cornell-cup/ece-minibot-pcb-sp16/minibot_final_sp16 (PCB - Pour Copper Report).txt

Pour Copper Report
------------------

Report File:        D:\Spring 2016\Minibot\ece-minibot-pcb-sp16\minibot_final_sp16 (PCB - Pour Copper Report).txt
Report Written:     Monday, May 09, 2016
Project Path:       D:\Spring 2016\Minibot\ece-minibot-pcb-sp16\minibot_final_sp16.prj
Design Path:        D:\Spring 2016\Minibot\ece-minibot-pcb-sp16\minibot_final_sp16.pcb
Design Title:       
Created:            5/3/2016 6:45:54 AM
Last Saved:         5/9/2016 8:59:37 PM
Editing Time:       950 min
Units:              mil (precision 2)

End Of Report.
