cornell-cup/ece-minibot-pcb-sp16/Mini-ModBot Hardware Integration - Port_Pin Mapping.xlsx

Sheet: Pin mapping by Aish
Mini-ModBot Hardware Integration - Port/Pin Mapping
System | Component (If Applicable) | Port/Pin# | Port/Pin Name | Port/Pin Conflict? | If Yes, Conflict Description | Other
Motor control
 | Motor (Back) | --- | PWM
 |  | --- | PWM
 | Encoder (Back) | --- | GPIO
 | Servo (Front) | --- | Connect to PIC
 | PIC | --- | SPI Line 1
 |  | --- | SPI Line 2
PS4 controller
 | Bluetooth | --- | Bluetooth
Temperature Sensor
 | LM35 | --- | Analog Pin |  |  | Currently MIA, Need to order another if not found
Color Sensor
 | Adafruit TCS34725 RGB Color Sensor | SDA | SDA (I2C)
 |  | SCL | SCL (I2C)
IMU
 | Adafruit - BNO055 - 9-DOF IMU | SDA | SDA (I2C)
 |  | SCL | SCL (I2C)
LIDAR
 | Neato LIDAR XV-11 | RX | UART
 |  | TX | UART
Camera
 | Logitech Webcam C525 | USB | USB
Power
 | Li-Ion 11.1V Rechargeable Battery | --- | Power Supply (ADC?) |  |  | Requires power regulator (integrated on PCB)
Battery Indicator
 | LED/Buzzer | --- | GPIO |  |  | Requires voltage divider (integrated on PCB)

Sheet: Pin mapping - Aparna
Mini-ModBot Hardware Integration - Port/Pin Mapping
System | Component (If Applicable) | Port/Pin Name | Shield Pin # | GPIO Pin # | Other pin options (shield pin) | Port/Pin Conflict? | If Yes, Conflict Description | Other
Motor control
 | Motor (Back) | PWM | ~3 | GP183 | ~5, ~6, ~9
 | Encoder (Back) | GPIO | 7 | GP48
 | Servo (Front) | Connect to PIC | ---
 | PIC | SPI SCK | 13 | GP109
 |  | SPI MISO | 12 | GP114
 |  | SPI MOSI | ~11 | GP115
 |  | SPI Signal select | ~10 | GP111
PS4 controller
 | Bluetooth | Bluetooth | ---
Temperature Sensor
 | LM35 | Analog Pin | A0 | GP44 | A2, A3 |  |  | Currently MIA, Need to order another if not found
Color Sensor
 | Adafruit TCS34725 RGB Color Sensor | SDA (I2C) | SDA
 |  | SCL (I2C) | SCL
IMU
 | Adafruit - BNO055 - 9-DOF IMU | SDA (I2C) | A4 (I2C6_SDA) | GP27
 |  | SCL (I2C) | A5 (I2C6_SCL) | GP28
LIDAR
 | Neato LIDAR XV-11 | UART | RX | GP130
 |  | UART | TX | GP131
Camera
 | Logitech Webcam C525 | USB | USB
Power
 | Li-Ion 11.1V Rechargeable Battery | Power Supply (ADC?) | A1 | GP45 | A2, A3 |  |  | Requires power regulator (integrated on PCB)
Battery Indicator
 | LED/Buzzer | GPIO | 8 | GP49 |  |  |  | Requires voltage divider (integrated on PCB)

Sheet: Reference for hardware
Table 8 in Hardware manual : | http://www.intel.com/content/dam/support/us/en/documents/edison/sb/edisonarduino_hg_331191007.pdf
GPIO Pin mapping : | Table 2 - Shield pin GPIO mapping | http://www.intel.com/content/dam/support/us/en/documents/edison/sb/edisonarduino_hg_331191007.pdf

Sheet: Pin mapping - Tahmid
Mini-ModBot Hardware Integration - Port/Pin Mapping
System | Component (If Applicable) | Port/Pin Name | Shield Pin # | GPIO Pin # | Other pin options (shield pin) | Port/Pin Conflict? | If Yes, Conflict Description | Other
Motor control
 | Motor (Back) | PWM | ~3 | GP183 | ~5, ~6, ~9
 |  | PWM | ~5
 | Encoder (Back) | GPIO | 7 | GP48
 | Servo (Front) | Connect to PIC | ---
 | PIC | SPI SCK | 13 | GP109
 |  | SPI MISO | 12 | GP114
 |  | SPI MOSI | ~11 | GP115
 |  | SPI Signal select | ~10 | GP111
PS4 controller
 | Bluetooth | Bluetooth | ---
Temperature Sensor | x2
 | LM35 | Analog Pin | A0 | GP44 | A2, A3 |  |  | Currently MIA, Need to order another if not found
Color Sensor
 | Adafruit TCS34725 RGB Color Sensor | SDA (I2C) | SDA
 |  | SCL (I2C) | SCL
IMU
 | Adafruit - BNO055 - 9-DOF IMU | SDA (I2C) | A4 (I2C6_SDA) | GP27
 |  | SCL (I2C) | A5 (I2C6_SCL) | GP28
LIDAR
 | Neato LIDAR XV-11 | UART | RX | GP130
Camera
 | Logitech Webcam C525 | USB | USB
Power
 | Li-Ion 11.1V Rechargeable Battery | Power Supply (ADC?) | A1 | GP45 | A2, A3 |  |  | Requires power regulator (integrated on PCB)
Battery Indicator
 | LED/Buzzer | GPIO | 8 | GP49 |  |  |  | Requires voltage divider (integrated on PCB)
2x motor drive
Detecting when charger is plugged in |  | Disable motors, lidar and rgb
Charger mounted on top of rear motor bracket
No TFT LCD for this rev
2x LM35 - mount 1 on battery (?) and 1 for surroundings
2 GPIOs for RGB LED
Power Regulator
Reverse voltage protection
Check all 3.3V nets
Find bulk capacitors
Break out edison analog pins |  | http://www.digikey.com/product-detail/en/sullins-connector-solutions/PPPC031LFBN-RC/S7036-ND/810175
Break out edison uart pins |  | http://www.digikey.com/product-detail/en/sullins-connector-solutions/PPPC031LFBN-RC/S7036-ND/810175
Allow connecting edison aref/ioref to onboard psu
Break out 5V/3.3V outputs |  | http://www.digikey.com/product-detail/en/sullins-connector-solutions/PPTC051LFBN-RC/S6103-ND/807239
Switch |  | http://www.digikey.com/product-detail/en/c-k-components/1101M2S4AQE2/CKN5050-ND/483720
Fuse/circuit breaker
Removed decoupling cap on IMU - C1
Lidar switch for switching between 3.3V/5V
PIC inductor on AVDD/Vss
Unused IO pull-down?
MCLR connection cap?
AREF/IOREF on Edison
