cornell-cup/ece-minibot-pcb-sp16/battery indicator.PNG

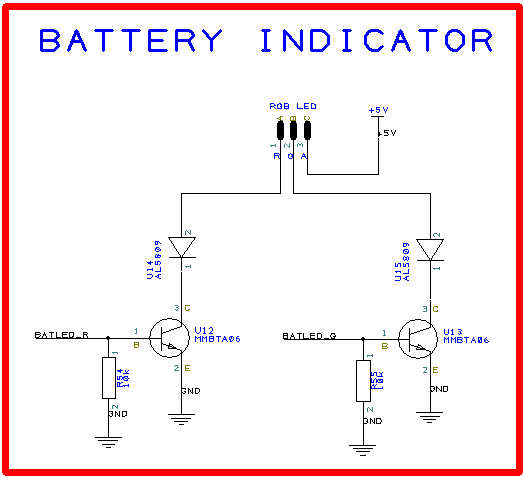
battery indicator.PNG
