cornell-cup/ece-minibot-pcb-sp16/charging.png

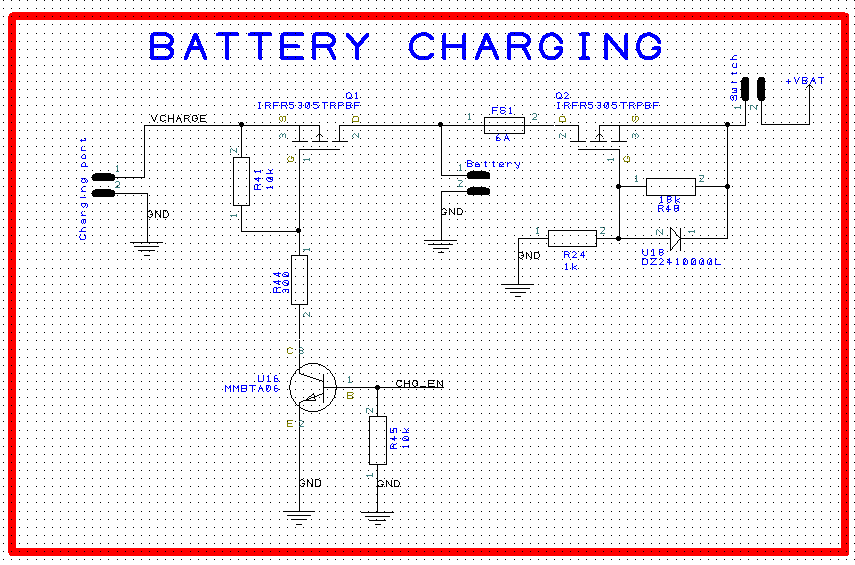
charging.png
