cornell-cup/ece-minibot-pcb-sp16/edison.png

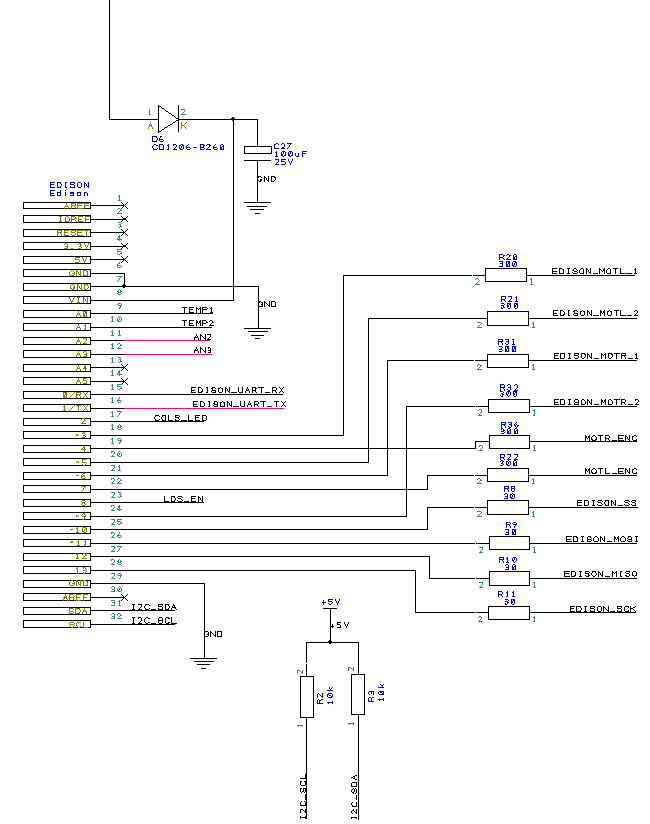
edison.png
