cornell-cup/ece-minibot-pcb-sp16/lidar.PNG

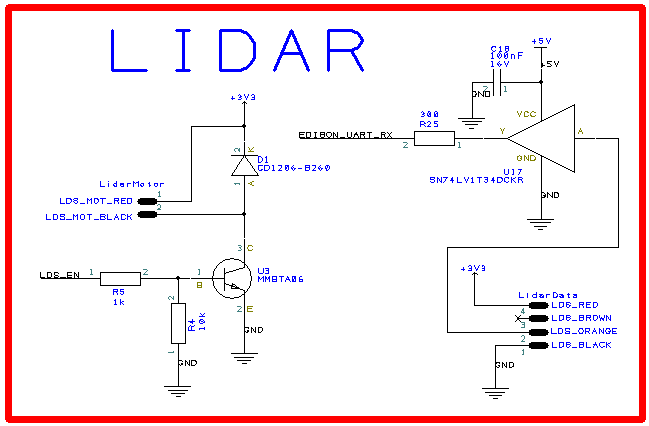
lidar.PNG
