cornell-cup/ece-minibot-pcb-sp16/motor driver.png

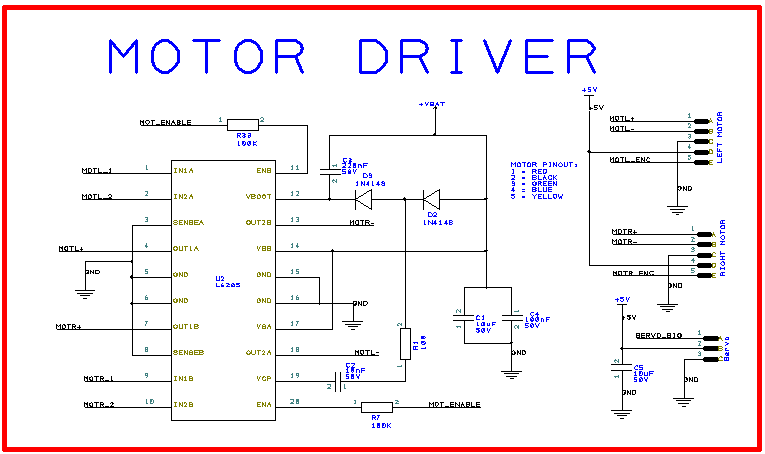
motor driver.png
