cornell-cup/ece-minibot-pcb-sp16/mux.PNG

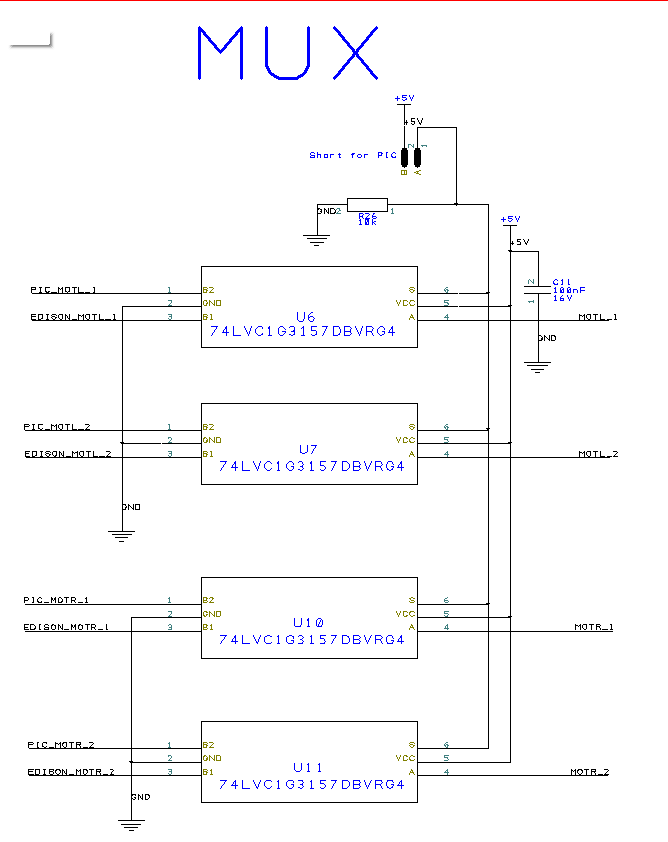
mux.PNG
