cornell-cup/ece-minibot-pcb-sp16/pic32.PNG

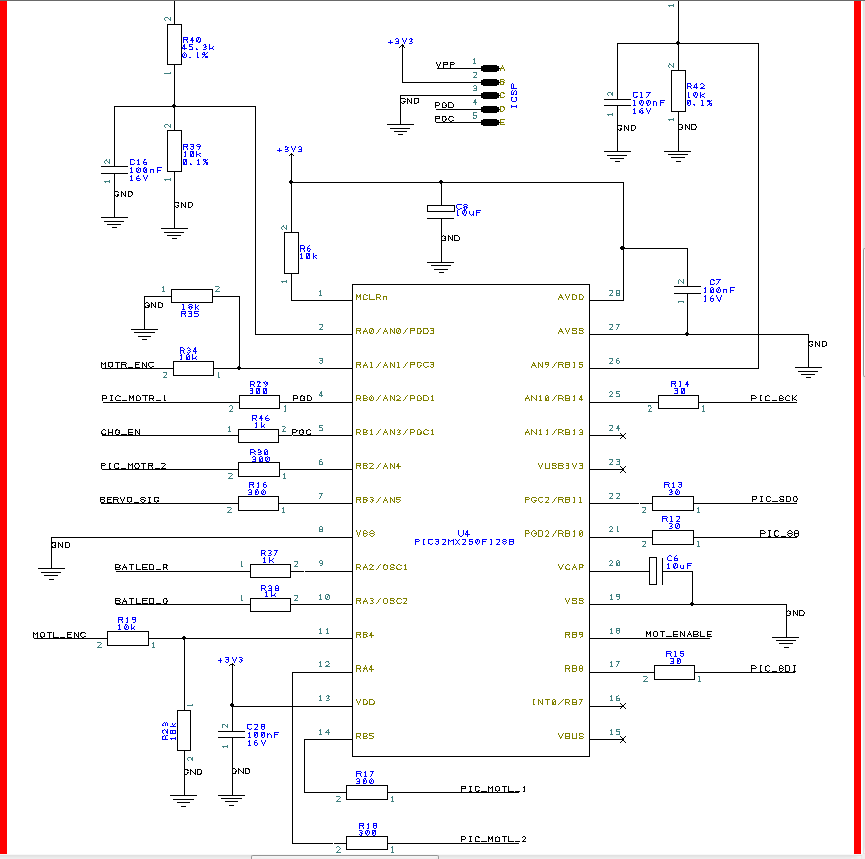
pic32.PNG
