cornell-cup/ece-minibot-pcb-sp16/power.png

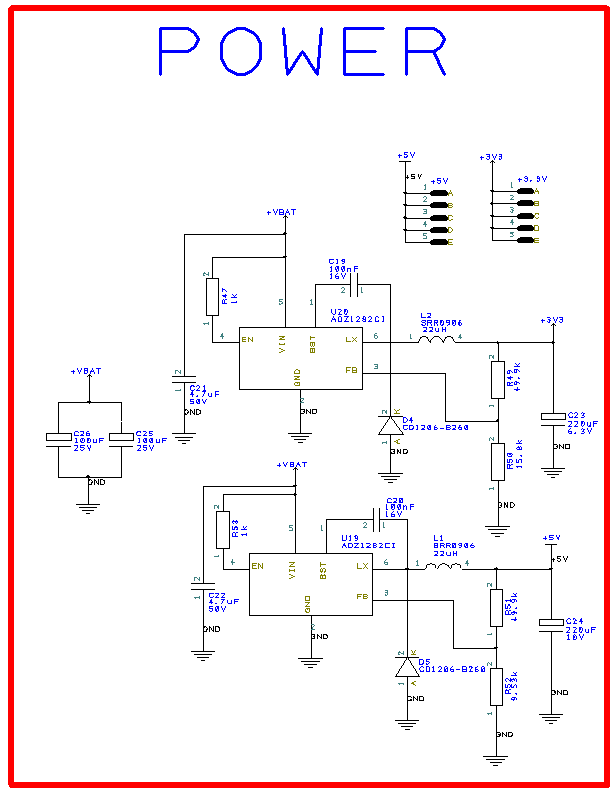
power.png
