cornell-cup/ece-minibot-pcb-sp16/temperature sensors.PNG

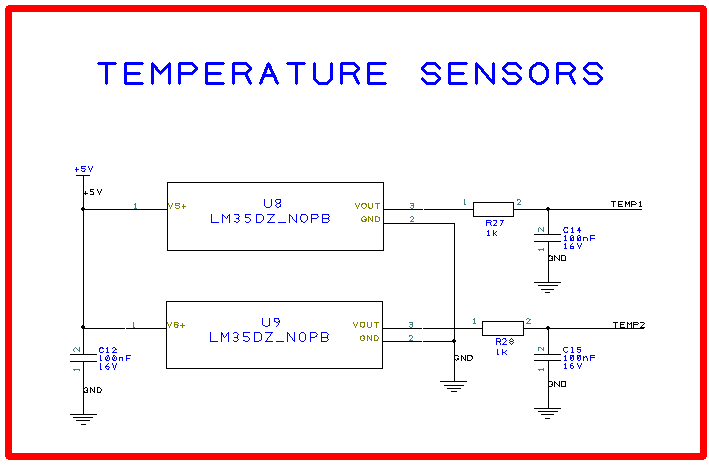
temperature sensors.PNG
