cornell-cup/ece-minibot-pcb-sp16/Schematic Design_ minibot_final_sp16.pdf

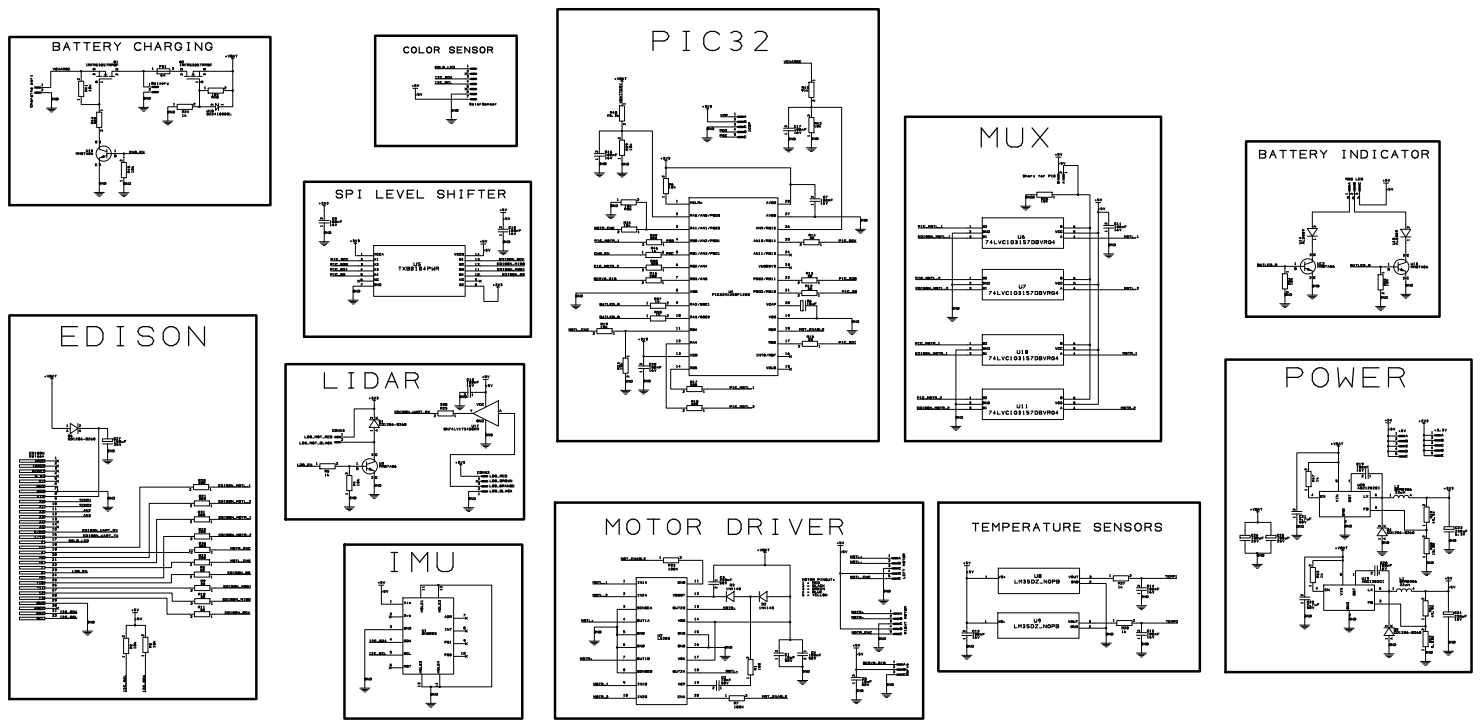
[picture p10: page 1]
