cornell-cup/ece-minibot-pcb-sp16/(list of files, drawings)

Other design files:
minibot_final_sp16.pcb
~minibot_final_sp16.pcb
