cornell-cup/ece-minibot-pcb-sp16/(commit log)

2016-05-03 Things are still being added to schematic. PIC32 added!
    [minibot_final_sp16.pcb, minibot_final_sp16.sch, ~minibot_final_sp16.sch]
2016-05-03 Still adding components on first pass
    [minibot_final_sp16.sch, ~minibot_final_sp16.sch]
2016-05-04 Adding more of the circuit in place to the schematic. Also, added excel pins list.
    [minibot_final_sp16.sch, ~minibot_final_sp16.sch]
2016-05-04 More things added to schematic
    Power, battery charging (and detection/prevention), color sensor,
    battery indicated (RGB LED driver) left to be added. Then, it should be
    complete.
    [Mini-ModBot Hardware Integration - Port_Pin Mapping.xlsx, minibot_final_sp16.pcb, minibot_final_sp16.sch, ~minibot_final_sp16.sch]
2016-05-04 LED driver and ICSP header added.
    [minibot_final_sp16.sch, ~minibot_final_sp16.sch]
2016-05-05 Schematic mostly done
    Power regulators, color sensor, ... placed in schematic. Now need to
    make sure nothing is left out. And pick connector for battery.
    [Mini-ModBot Hardware Integration - Port_Pin Mapping.xlsx, minibot_final_sp16.sch, ~minibot_final_sp16.sch]
2016-05-05 Mostly complete. Reviewing.
    [Mini-ModBot Hardware Integration - Port_Pin Mapping.xlsx, minibot_final_sp16.pcb, minibot_final_sp16.sch, ~minibot_final_sp16.sch]
2016-05-06 Only switch left to be placed on schematic
    [Mini-ModBot Hardware Integration - Port_Pin Mapping.xlsx, minibot_final_sp16.sch, ~minibot_final_sp16.sch]
2016-05-06 Switch still left. Couple points of feedback from Aparna incorporated.
    [Mini-ModBot Hardware Integration - Port_Pin Mapping.xlsx, minibot_final_sp16.pcb, minibot_final_sp16.sch]
2016-05-07 Replacing 1206 resistors with 0603
    All 10k and 300 ohms resistors have been replaced.
    [minibot_final_sp16.pcb, minibot_final_sp16.sch]
2016-05-07 Replaced 1k resistors to 0603
    [minibot_final_sp16.pcb, minibot_final_sp16.sch]
2016-05-07 All resistors except precision ones changed to 0603
    [minibot_final_sp16.sch]
2016-05-07 Replacing the 1206 capacitors
    [minibot_final_sp16.pcb, minibot_final_sp16.sch]
2016-05-07 Renamed connectors and named all nets
    [minibot_final_sp16 (bill of materials CSV).csv, minibot_final_sp16.pcb, minibot_final_sp16.sch]
2016-05-07 Actually renamed everything correctly.
    Started thinking about component placement on board.
    [minibot_final_sp16.pcb, minibot_final_sp16.sch]
2016-05-07 Updated pdf view of schematic
    [minibot_final_sp16.pcb, minibot_final_sp16.sch]
2016-05-07 Power components grouped together
    [minibot_final_sp16.pcb, minibot_final_sp16.sch, ~minibot_final_sp16.pcb]
2016-05-07 RGB, Ilimit Res
    RGB block grouped together. Edison current limiting and "terminating"
    resistors placed near header.
    [minibot_final_sp16.pcb]
2016-05-07 Motor and lidar drivers grouped together
    [minibot_final_sp16.pcb]
2016-05-07 Res and PIC
    Some 1206 resistors were left. They were changed to 0603. Additionally,
    the PIC components were grouped together.
    [minibot_final_sp16.pcb, minibot_final_sp16.sch, ~minibot_final_sp16.pcb, ~minibot_final_sp16.sch]
2016-05-07 Everything grouped together
    [minibot_final_sp16.pcb, minibot_final_sp16.sch]
2016-05-07 End for the night.
    All grouping completed. Now, need to place component groups on board and
    complete routing.
    [minibot_final_sp16.pcb]
2016-05-09 Relaying parts
    [minibot_final_sp16.pcb, minibot_final_sp16.sch]
2016-05-09 Mostly done with placement
    [minibot_final_sp16.pcb, minibot_final_sp16.sch]
2016-05-09 Placement complete. Start routing.
    [minibot_final_sp16.pcb, minibot_final_sp16.sch]
2016-05-09 Partial routing
    [minibot_final_sp16.pcb, minibot_final_sp16.sch]
2016-05-09 More partial layout
    [minibot_final_sp16.pcb, minibot_final_sp16.sch, ~minibot_final_sp16.sch]
2016-05-09 Almost complete layout
    [minibot_final_sp16.pcb, minibot_final_sp16.sch]
2016-05-09 More routing being done
    [minibot_final_sp16.pcb, minibot_final_sp16.sch, ~minibot_final_sp16.sch]
2016-05-09 Still routing - pcb artist is being buggy
    [minibot_final_sp16.pcb, minibot_final_sp16.sch, ~minibot_final_sp16.sch]
2016-05-09 A few nets left
    [minibot_final_sp16.pcb, minibot_final_sp16.sch]
2016-05-10 GND and VBATTERY net left
    Everything else is routed. All manufacturing and spacing DRC complaints
    have been fixed.
    [minibot_final_sp16.pcb, minibot_final_sp16.sch, ~minibot_final_sp16.sch]
2016-05-10 Complete. Check once more and add labels to connectors
    [minibot_final_sp16.pcb]
2016-05-10 Minor aesthetic change
    [minibot_final_sp16.pcb]
2016-05-11 Board and parts ordered
    [minibot_final_sp16 (bill of materials ref des csv).csv, minibot_final_sp16.sch]
